ut-robotics/picr21-team-tlo-rock/README.md

# picr21-team-tlo-rock

The robot assigned name is 'TLOROCK'.

Running this code requires the installation of the following external python libraries beforehand:
- pyrealsense2
- cv2
- numpy
- pynput
- websockets
    
To run the python portion of the code navigate to the folder 'robot code' and run the 'main.py' file.    

To run the mainboard code import the tlo project into cube IDE and connect the mainboard to it via ST link. Then press the run button and it should upload it to the mainboard. The mainboard must be connected to a power source via its usb connection.
