ut-robotics/picr21-team-tlo-rock/testing files/camera line concept.png

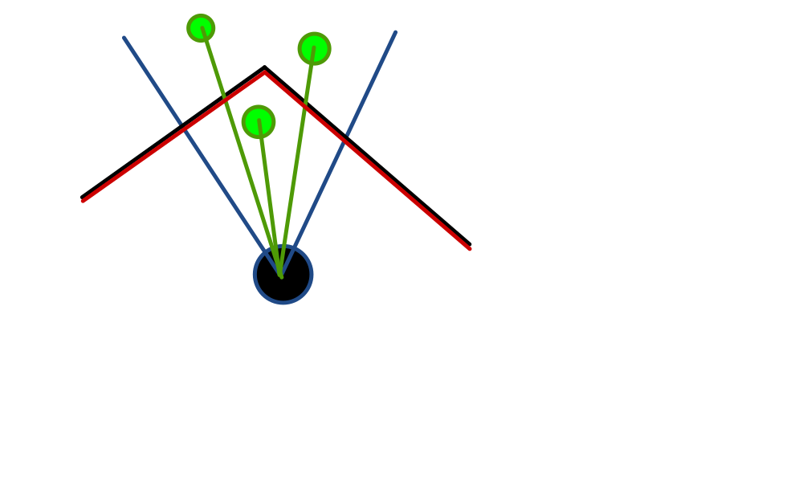
testing files/camera line concept.png
