ut-robotics/picr21-team-tlo-rock/electronics/Mainboard documentation/Mainboard BOM.xlsx

Comment | Description | Designator | Footprint | LibRef | Quantity
Cap Semi | Capacitor (Semiconductor SIM Model) | C1, C2, C3, C4, C5, C6, C10, C10_MOTOR_DRIVE_1, C10_MOTOR_DRIVE_2, C10_MOTOR_DRIVE_3, C11, C11_MOTOR_DRIVE_1, C11_MOTOR_DRIVE_2, C11_MOTOR_DRIVE_3, C13, C13_MOTOR_DRIVE_1, C13_MOTOR_DRIVE_2, C13_MOTOR_DRIVE_3, C14, C15, C16, C17, C18, C19, C20, C21, C22, C23, C24, C25, C26, C27, C28, C29, C30, C31, C32, C33, C34 | 1608[0603] | Cap Semi | 39
470u | 470F 25V Aluminum Electrolytic Capacitors Radial, Can 8000 Hrs @ 105C | C12_MOTOR_DRIVE_1, C12_MOTOR_DRIVE_2, C12_MOTOR_DRIVE_3 | CAPPRD500W60D800H1500 | EEUFR1E471YB | 3
3V3_GOOD | Typical RED, GREEN, YELLOW, AMBER GaAs LED | D1 | 1608[0603] | LED2 | 1
B5V_GOOD | Typical RED, GREEN, YELLOW, AMBER GaAs LED | D2 | 1608[0603] | LED2 | 1
LED | Typical RED, GREEN, YELLOW, AMBER GaAs LED | D3 | 1608[0603] | LED2 | 1
LED2 | Typical RED, GREEN, YELLOW, AMBER GaAs LED | D4_MOTOR_DRIVE_1, D4_MOTOR_DRIVE_2, D4_MOTOR_DRIVE_3 | 1608[0603] | LED2 | 3
10118193-0001LF | USB - micro B USB 2.0 Receptacle Connector 5 Position Surface Mount, Right Angle; Through Hole | J1 | FCI_10118193-0001LF | 10118193-0001LF | 1
FTSH-105-01-XXX-DV-K | TERMINAL STRIP, .050"(1.27mm) PITCH, 10 PINS, KEYED | J2 | FTSH-105-01-XXX-DV-K | FTSH-105-01-XXX-DV-K | 1
7-215079-4 | Micro-MaTch 4 Position 1.27 mm Pitch Vertical Female-on-Board Connector | J3, J4, J5, J6, J7, J8, J9 | TE_7-215079-4 | 7-215079-4 | 7
Inductor | Inductor | L1 | WE-PD-M-PB | Inductor | 1
BAT+ |  | P1 | PCBComponent_1 | Component_1 | 1
BAT- |  | P2 | PCBComponent_1 | Component_1 | 1
M1+ |  | P3 | PCBComponent_1 | Component_1 | 1
M1- |  | P4 | PCBComponent_1 | Component_1 | 1
M2+ |  | P5 | PCBComponent_1 | Component_1 | 1
M2- |  | P6 | PCBComponent_1 | Component_1 | 1
M3+ |  | P7 | PCBComponent_1 | Component_1 | 1
M3- |  | P8 | PCBComponent_1 | Component_1 | 1
BUK6Y10-30P | P-Channel MOSFET | Q1 | TO127P600X120-5N | MOSFET-P | 1
Res2 | Resistor | R1, R2, R3, R4, R5, R6 | J1-0603 | Res2 | 6
Rsr | Resistor | R10_MOTOR_DRIVE_1, R10_MOTOR_DRIVE_2, R10_MOTOR_DRIVE_3 | J1-0603 | Res3 | 3
Rdiag | Resistor | R11_MOTOR_DRIVE_1, R11_MOTOR_DRIVE_2, R11_MOTOR_DRIVE_3 | J1-0603 | Res3 | 3
Rmode | Resistor | R12_MOTOR_DRIVE_1, R12_MOTOR_DRIVE_2, R12_MOTOR_DRIVE_3 | J1-0603 | Res3 | 3
Rtrip | Resistor | R13_MOTOR_DRIVE_1, R13_MOTOR_DRIVE_2, R13_MOTOR_DRIVE_3 | J1-0603 | Res3 | 3
R|PROP| | Resistor | R14_MOTOR_DRIVE_1, R14_MOTOR_DRIVE_2, R14_MOTOR_DRIVE_3 | J1-0603 | Res3 | 3
Rled | Resistor | R15_MOTOR_DRIVE_1, R15_MOTOR_DRIVE_2, R15_MOTOR_DRIVE_3 | J1-0603 | Res3 | 3
CM1223 |  | U1 | SOT23-5 | CM1223 | 1
PDRV8243HRXYQ1 | No Description Available | U1_MOTOR_DRIVE_1, U1_MOTOR_DRIVE_2, U1_MOTOR_DRIVE_3 | RXY0014A-MFG | PDRV8243HRXYQ1 | 3
STM32G441KBT3 | No Description Available | U2 | LQFP32_7X7_STM | STM32G441KBT3 | 1
NCP164C |  | U3 | SOT23-5 | NCP164C | 1
MAX14930 |  | U5, U6, U7 | SOIC16_N | MAX14930 | 3
TPS54227DDA |  | U8 | VREG_LM5017MR/NOPB | TPS54227DDA | 1
