ut-robotics/picr21-team-tlo-rock/electronics/c_comp/ul_STM32G441KBT3/AltiumDesigner/2021-09-23_16-13-24/LQFP32_7X7_STM.step

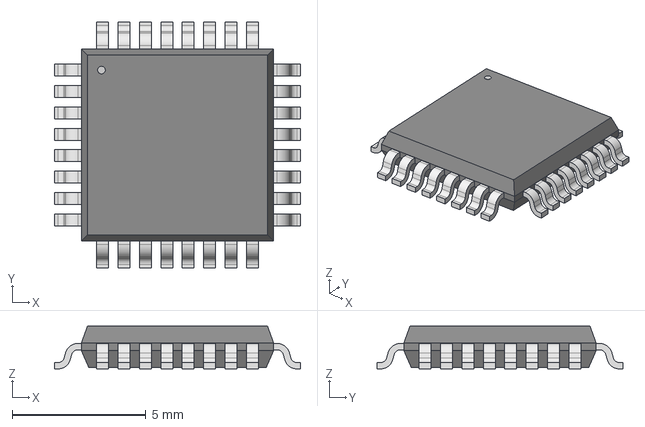
[picture p2: CAD file, 2021-11-29]
electronics/c_comp/ul_STM32G441KBT3/AltiumDesigner/2021-09-23_16-13-24/LQFP32_7X7_STM.step
9.19 x 9.19 x 1.60 mm
