ut-robotics/picr21-team-tlo-rock/(threads)

Thread 16 (2021-10-23):

Use serial.tools.list_ports

ReikoR, 2021-10-23:
https://github.com/ut-robotics/picr21-team-tlo-rock/blob/62c4f6e3b51b6864e3e0457cb11f78cf762dd253/robot%20code/movement_controller.py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

Instead of blindly trying to open ports, use [serial.tools.list_ports](https://pyserial.readthedocs.io/en/latest/tools.html) to find the correct port based on the port info.

peeter-virk, 2021-11-04:
now using serial.tools.list_ports to connect to the board

Closed 2021-11-06.

Thread 20 (2021-10-23):

Simplify omni-movement code

ReikoR, 2021-10-23:
Separate `rotate_omni` function should not be needed. Rotation speed could be an argument of `move_omni` function and added to each wheel speed.

`combine_moves` should also not be needed. In `manual_control.py`, movement speed and angle could be calculated based on the button presses and used as a argument for `move_omni` function. Other uses of `combine_moves` should also be unnecessary when rotation speed is added as an argument to `move_omni` function.

peeter-virk, 2021-11-04:
Change is not worth the time and effort it would take to modify large parts of the current code as well as having to fix all of the potential bugs related to refactoring.

Closed 2021-11-09.

Thread 24 (2021-11-06):

[Mechanics] - motor holder design tweaks

Akustav, 2021-11-06:
2 enhancements:
1. Reduce the radius of the holder, this makes creating it faster and wastes less material
2. Put the shaft fastening hole between the wheel fastening holes. This way there can be no interference bewteen the two fasteners

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

priitro, 2021-11-06:
1. Reduced motor holder radius to 28 mm.
2. Positioned holes around, and now interference will be between two different fasteners.
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
Motor holder sketch
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

Akustav, 2021-11-06:
Maybe we can make it 25? Then we can use 25mm materials

priitro, 2021-11-06:
Its is possible now - diameter is 25 mm and 2 mm from edge of hole to perimeter
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

Akustav, 2021-11-07:
Seems ok now

Closed 2021-11-07.

Thread 25 (2021-11-06):

[Mechanics] - sketch has underdefined elements

Akustav, 2021-11-06:
Check that sketches have no underdefined elements, so they need to be black, not blue:

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

priitro, 2021-11-06:
Changed holes position and defined whit constraints  sketch.
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

Akustav, 2021-11-06:
Seems OK now

Closed 2021-11-06.

Thread 26 (2021-11-07):

[Mechanics] - wheel could damage field elements or robots

Akustav, 2021-11-07:
When the wheel is spinning it could damage parts of the fields (baskets) or robots it hits with bolt heads. You you plan to cover the wheels?

I not maybe recessed screws are better.

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

priitro, 2021-11-07:
1.I have designed wheel cover. I (we - others don't now yet about it ) haven't decided yet use it or not. If we use cover we can use same screws, if not i can change screws type and redesign holes.
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

2. Bottom plate design is`'t ready yet and i don't know whether we use protective edge or not. Right now i have placed motors and wheels to bottom plate and we may have space for edge on it.
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

Akustav, 2021-11-07:
Okay, Seems like you have considered it. Will close

priitro, 2021-11-07:
I redesigned holes - now I can use both screws depending of whether I use cower or not:  Design of screw may be bad but it gives idea I mean.
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

Closed 2021-11-07.

Thread 33 (2021-11-24):

Wrong motor driver package

ReikoR, 2021-11-24:
HVSSOP (28) package is used, but the available drivers are in VQFN-HR (14) package.

Package is also specified in the guide:
https://reikor.github.io/picr21-basketball-robot-guide/electronics/components.html#_motor_driver

JoelJaemaa, 2021-11-29:
New footprint has no thermal pad under it, I will draw that in manually

ReikoR, 2021-12-04:
Still wrong footprint and symbol.

Recommended (available in the lab) component:
https://reikor.github.io/picr21-basketball-robot-guide/electronics/components.html#_motor_driver
>DRV8243
>Product code: PDRV8243HRXYQ1 (HW variant)
>Package: VQFN-HR (14)

From the datasheet:
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

ReikoR, 2021-12-08:
It probably doesn't matter too much, but it would be nice to keep minimum solder mask expansion.

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

JLCPCB specifies the minimum at 0.05 mm.
https://jlcpcb.com/capabilities/Capabilities

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

[Datasheet ](https://www.ti.com/lit/ds/symlink/drv8243-q1.pdf) recommends 0.05 mm.

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

JoelJaemaa, 2021-12-13:
I can't seem to find this in the rules. There is a rule in design rules -> mask -> solder mask expansion -> expansion top and it's set at 4 mil.

ReikoR, 2021-12-14:
For this component it's defined on the component footprint. Component library needs to be changed.

Closed 2022-01-07.

Thread 34 (2021-11-24):

Incorrect microcontroller pins used

ReikoR, 2021-11-24:
USB and programmer signals can be connected only to specific pins. PWM output and encoder input signals can also be connected to limited amount of pins.

Recommended way for finding correct pins is to use Pinout & Configuration view in STM32CubeIDE.

More information can be found on the firmware page in the guide:
https://reikor.github.io/picr21-basketball-robot-guide/electronics/firmware.html

JoelJaemaa, 2021-11-29:
Updated the pins. Let me know if these are okay now

ReikoR, 2021-12-04:
Servo needs a separate timer as it needs different PWM frequency from motors and thrower. PB0 pin does not have any usable timer currently.
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

What interface is accelerometer using? I2C? PA5 and PA10 pins are not connected to anything usable in the MCU.
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

Closed 2021-12-12.

Thread 35 (2021-11-24):

Analog signal can't go through digital isolator

ReikoR, 2021-11-24:
MAX14930 is a digital isolator and the outputs are either low or high.
Some other solution would be needed for measuring voltages on the other side of an isolator.

What is the purpose of measuring battery voltage?

JoelJaemaa, 2021-11-29:
Peeter wanted the ability to measure battery voltage so that we can compensate for speed as the battery voltage drops

ReikoR, 2021-12-04:
Compensate for wheel speeds or thrower speeds?

Wheel motors have encoders for closed loop speed control and voltage regulator can be used to keep the thrower motor controller voltage constant.

Closed 2021-12-12.

Thread 36 (2021-11-24):

Use 0603 package for resistors and smaller capacitors

ReikoR, 2021-11-24:
Most of the passive components in the lab are in 0603 package but some components on the schematic are in 0805 package. It doesn't make sense to order new components if the components with same values are available. For higher capacitances it's ok to use larger packages, but it's better to check what's already available in the lab.

JoelJaemaa, 2021-11-29:
Changed 0805 footprints to 0603

ReikoR, 2021-12-04:
There are still components in 0805 package.

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

JoelJaemaa, 2021-12-06:
Fixed

Closed 2021-12-08.

Thread 37 (2021-11-24):

NCV8730ASN500T1G does not have PG

ReikoR, 2021-11-24:
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

From the [datasheet](https://www.onsemi.com/pdf/datasheet/ncv8730-d.pdf):

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

JoelJaemaa, 2021-11-29:
Removed the LED and resistor atttached to the PG pin and connected them to +5v motor rail and GND instead for checking if we have the voltage.

Closed 2021-12-04.

Thread 38 (2021-11-24):

Use cheaper and simpler connector for GPIO

ReikoR, 2021-11-24:
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

Programmer connector is not very cheap. It has 1.27 mm pitch and is keyed, requiring matching connector to be used.

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

We have pin headers in the lab with 1.27, 2.0 and 2.54 mm pitch and also micromatch connectors with different pin counts.
If really needed, then we can order something else.

JoelJaemaa, 2021-11-29:
Replaced with micromatch 4 connectors for individual addon features

Closed 2021-12-04.

Thread 39 (2021-11-24):

LED is connected in a wrong way to DRV8243 nFAULT pin

ReikoR, 2021-11-24:
Some more info on how to use open drain pins:
https://reikor.github.io/picr21-basketball-robot-guide/electronics/schematic.html#_open_drain_outputs

JoelJaemaa, 2021-11-29:
Yep, accidentaly left that the wrong way around. Fixed it.

Closed 2021-12-04.

Thread 40 (2021-11-24):

Select correct resistors for DRV8243 configuration pins

ReikoR, 2021-11-24:
Some pins can be connected directly to GND, left unconnected or connected with specific resistor to GND.

For example currently ITRIP pin is connected to GND with a 0 Ohm resistor, which results in output current not being limited. I would recommended current limit of around 2 to 3 A. Current limit can be set with resistors connected to ITRIP and IPROPI pins.

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

Relevant information can be found from the datasheet:
https://www.ti.com/lit/ds/symlink/drv8243-q1.pdf

Let me know if more help is needed.

JoelJaemaa, 2021-12-06:
The resistors in the schematic are currently just placeholders so they could be placed on the pcb. I will update them soon.

JoelJaemaa, 2022-01-13:
Changed ITRIP resistor to 47K. Does that seem okay? Rest of them should be fine at 0 ohm (GND)?

ReikoR, 2022-01-14:
Resistor values should be fine, but place the resistor better on the schematic. Currently it's a bit hard to understand which is which.  It would be better to place resistors vertically.

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

JoelJaemaa, 2022-01-24:
Resistor placement fixed. Made other schematic elements nicer as well. Changed the values of feedback resistors in the switching regulator with values that were available in the lab. Same ratio. 5V is nice and stabile.

Closed 2022-01-25.

Thread 44 (2021-11-28):

Refactor min max limiting into separate function

ReikoR, 2021-11-28:
https://github.com/ut-robotics/picr21-team-tlo-rock/blob/f928aeb4cd5ac96405098a886fadbd8b1d98b824/robot%20code/game_logic.py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

peeter-virk, 2021-12-06:
done

ReikoR, 2021-12-10:
https://github.com/ut-robotics/picr21-team-tlo-rock/blob/8d38ac2402675cea33a5d87779682db3a0426ee8/robot%20code/game_logic.py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

Current `minimax` function won't work, because it uses the same names for arguments as built-in functions `min` and `max`.

peeter-virk, 2021-12-11:
Fixed in main

Closed 2021-12-13.

Thread 45 (2021-11-28):

Duplicate camera code

ReikoR, 2021-11-28:
`Camera.py` and `Thresholding.py` contain duplicate camera code.

It would be better to have separate Camera class that can be used for getting frames for regular image processing and thresholding.

Kuulike, 2021-12-06:
moved the thresholding tool into the testing code package

ReikoR, 2021-12-10:
Is the code in `Thresholding.py` not used any more?

Camera code should be in  separate file/class so it can be used by both thresholding and main robot code without duplicating it.

peeter-virk, 2022-01-13:
files have been merged

ReikoR, 2022-01-14:
Putting everything in the same file is not the best solution, but better than before.

Closed 2022-01-14.

Thread 47 (2021-12-04):

Add decoupling capacitor to VDDA

ReikoR, 2021-12-04:
Each VDD/VDDA pin should have separate 100nF capacitor.

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

JoelJaemaa, 2021-12-06:
I placed them near the pins on the PCB. I can correct it in the schematic as well.

ReikoR, 2021-12-08:
There should be additional 100nF capacitor, so that each VDD/VDDA pin would have one.

Closed 2021-12-12.

Thread 48 (2021-12-04):

Wrong package for isolators

ReikoR, 2021-12-04:
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

MAX14930DASE+ isolators are in narrow SOIC package. Wide SOIC package is currently used in the design.

JoelJaemaa, 2021-12-06:
Okay, will fix it

JoelJaemaa, 2021-12-11:
Fixed

Closed 2021-12-12.

Thread 49 (2021-12-04):

Incorrect BUK6Y10-30P symbol

ReikoR, 2021-12-04:
Symbol has 2 extra pins floating around.

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

Only 3 signals are connected to the footprint.

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

In the case where 1 pin connects to multiple pads it's better to use letters as designators instead of numbers:

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

D - drain
S - source
G - gate

Designators with the same name will be connected together. This way the symbol only needs 3 pins.

JoelJaemaa, 2021-12-06:
Fixed it

Closed 2021-12-08.

Thread 53 (2021-12-08):

Use switching regulator for servo power

ReikoR, 2021-12-08:
Linear regulators waste a lot of power when currents are high and voltage difference is big.

JoelJaemaa, 2021-12-11:
Okay, I'll look into it but that linear regulator should work okay for now. It will dissipate more heat but it has a small load and the batteries should be able to handle it. If I have time I will replace it on monday but if not then can we keep it this way? I have the part, no need to order it.

ReikoR, 2021-12-12:
Some recommendations:

1. You can use Texas Instruments Webench to generate the design for the regulator:
https://www.ti.com/design-resources/design-tools-simulation/webench-power-designer.html
Other manufacturers have similar tools available.

2. Check that the regulator is in stock:
https://www.mouser.ee/c/power/power-management-ics/voltage-regulators-switching-regulators/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
There are also some regulators in the lab from last year.

It's not that the batteries are not able to handle it. Linear regulators waste a lot of power. The load from servo is not that small.

JoelJaemaa, 2021-12-13:
Okay. I'll do this tonight.

JoelJaemaa, 2021-12-13:
I'll come by the lab tomorrow and check what we have. Everything the TI Webench recommended is out of stock or on order. I know that a linear regulator is not a good option but I put it in initially because it's what I have. I also do stuff for Estcube so I'll check if we have anything in stock there that I could get. Other than moving stuff from M1 layer and this regulator issue, everything else should be better now.

ReikoR, 2021-12-15:
I ordered these regulators:
https://www.ti.com/product/TPS62933

You can use those or the ones you find in the lab.

I'll probably order these inductors also:
https://ee.farnell.com/bourns/srp6060fa-5r6m/inductor-shld-5-6uh-10a-aec-q200/dp/2901832?st=2901832

JoelJaemaa, 2021-12-15:
Found a couple TPS54227s in the lab. Will use those. I did not check what size inductors we have though.

JoelJaemaa, 2021-12-15:
Schematics and board have been updated with TPS54227 based buck converter

ReikoR, 2021-12-15:
1. Vias in TPS54227 footprint are not connected to GNDB.

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

Footprint has pad 9, but symbol does not have pin 9, so the pad is not connected to anything.

Also it's better to add vias in PCB design not in component footprint. Then it's easier to change via sizes and locations.

2. Inductor used right now is in 1206 (3216 metric) size. I don't think there are any inductors in that size that can meet the recommended specs. TI Webench recommends: L: 4.7 μH - 7.05 μH, DCR: 125 mΩ (max), IDC: 3.64 A (min).

3. More input capacitance should be used. Current values are below the recommendations. It's probably better to use higher capacitance than recommended, because the servo motor could have high peak current draw.

JoelJaemaa, 2021-12-17:
I'd like to change it but this is a downloaded library and not one that I made. So the vias are already there. I'd like to remove the vias and add pin 9. Also edit the other footprints to move stuff around between mechanical layers. How can I do that?

I added more capacitance to the input.

ReikoR, 2021-12-18:
You can open the existing library files and modify them or you can create a new library yourself. It's easy to create components with Tools -> IPC Compliant Footprint Wizard.

JoelJaemaa, 2021-12-23:
Pin 9 GNDB issue fiexd

JoelJaemaa, 2021-12-23:
Proper inductor also used now

ReikoR, 2021-12-27:
1. Which exact inductor are you using in the design? Footprint in the design is for Würth Elektronik 744777930, but that one is not suitable. Würth has 4.7 uF inductors in similar package.

2. Move inductor closer to regulator.

Recommendation from [TPS54227 datasheet](https://www.ti.com/lit/ds/symlink/tps54227.pdf):

> 2\. Keep the SW node as physically small and short as possible to minimize parasitic capacitance and
inductance and to minimize radiated emissions. Kelvin connections should be brought from the output to the
feedback pin of the device.

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

3. Avoid routing anything below the inductor.

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

4. Output capacitance is still below the recommendations.

From TI Webench:

Cin = 20uF (2x 10uF)
Cout = 44uF (2x 22uF)

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

JoelJaemaa, 2021-12-29:
Using a 4.7uH inductor I found in the lab. Has the same footprint. Using this Würth part for the footprint.

JoelJaemaa, 2021-12-29:
Added more capacitance and shortened L1 path.

JoelJaemaa, 2021-12-31:
All issues should be fixed now

ReikoR, 2022-01-01:
This has not been fixed:

3\. Avoid routing anything below the inductor.

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

JoelJaemaa, 2022-01-02:
Fixed

ReikoR, 2022-01-02:
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

Linear regulator is not needed anymore, since the switching regulator can provide the 5V supply.

JoelJaemaa, 2022-01-03:
Removed it and put all the battery side 5V stuff onto the switching regulator

ReikoR, 2022-01-07:
Vias in TPS54227 footprint are again not connected to GNDB. It's better to remove vias from footprint and add them in PCB design.

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

JoelJaemaa, 2022-01-07:
Yeah it does not like to stay connected. Removed them from footprint and added manually. Should be fixed now.

Closed 2022-01-07.

Thread 54 (2021-12-08):

Servo connector should use motors side ground

ReikoR, 2021-12-08:
Currently servo connector is connected to MCU side ground.

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

JoelJaemaa, 2021-12-11:
Fixed

Closed 2021-12-12.

Thread 55 (2021-12-08):

Keep isolated sides completely separate

ReikoR, 2021-12-08:
MCU side and motors side should be physically separated on the board. Only things crossing the isolation gap should be the isolators.

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

JoelJaemaa, 2021-12-11:
Fixed

Closed 2021-12-12.

Thread 57 (2021-12-08):

Connect decoupling capacitors as close as possible to the components

ReikoR, 2021-12-08:
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

Track inductance should be minimized by keeping them as short as possible, otherwise decoupling capacitors won't be as effective.

JoelJaemaa, 2021-12-11:
Fixed

ReikoR, 2021-12-12:
Capacitors need to be much closer.

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

JoelJaemaa, 2021-12-13:
Fixed

ReikoR, 2021-12-15:
Decoupling capacitors for motor driver VM pins could be be closer to the drivers by putting capacitors to bottom layer and connecting them with vias.

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

JoelJaemaa, 2021-12-17:
Fixed. Also added an extra 4.7uf cap there. Moved both to bottom.

Closed 2021-12-27.

Thread 58 (2021-12-08):

Connect ESD protection as close as possible to connector

ReikoR, 2021-12-08:
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

Connecting ESD protection close to the connector helps to prevent ESD spikes from propagating to other components.

JoelJaemaa, 2021-12-11:
Fixed

Closed 2021-12-12.

Thread 59 (2021-12-08):

USB connector ground not connected

ReikoR, 2021-12-08:
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

JoelJaemaa, 2021-12-11:
Fixed

Closed 2021-12-12.

Thread 60 (2021-12-08):

Avoid routing ground

ReikoR, 2021-12-08:
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

Ground should be connected to internal ground layer(s) with vias as close as possible to component pads.

JoelJaemaa, 2021-12-11:
Fixed

ReikoR, 2021-12-12:
Vias should be as close as possible to pads to reduce inductance from tracks.

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

JoelJaemaa, 2021-12-13:
Fixed the long grounds

ReikoR, 2021-12-15:
This via could still be closer:
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

Why are you using the default via size everywhere? Vias can be smaller and moved closer to the pads.

Design rule for via sizes can be changed:
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

JoelJaemaa, 2021-12-17:
Used a smaller via and placed it closer.
I'm using default size because I did not necessarily need to use any other size before.

Closed 2021-12-27.

Thread 61 (2021-12-08):

Use wider tracks or polygons for higher currents

ReikoR, 2021-12-08:
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

JoelJaemaa, 2021-12-11:
I tried making some improvements. Hopefully it should be a bit better now.

ReikoR, 2021-12-12:
It's better, but you should move the tracks a bit and use smaller vias (at least for signals) to make power tracks for drivers wider.

Driver's VM capacitors should also be as close to the driver as possible. SMD capacitors can also be on the bottom of the board and connected with vias.

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

JoelJaemaa, 2021-12-13:
Will do it tonight

JoelJaemaa, 2021-12-13:
I managed to get the caps a bit closer and unchecked the option that removes loops from traces. This allowed me to get more vias on one trace and get the motor driver power connections connected from both sides.

Closed 2021-12-27.

Thread 62 (2021-12-08):

Board outline should be drawn on Mechanical 1 (M1) layer

ReikoR, 2021-12-08:
Currently it's on top layer, which is for top layer copper.

There are some other things on M1 layer, which should be moved to some other layers.

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

Component bodies are typically placed on M13 (Top 3D Body) or M14 (Bottom 3D Body) layers.

JoelJaemaa, 2021-12-11:
Moved outline to M1. Can't move other stuff on M1 to M13 or M14. It only lets me choose top, bottom or the two middle GND layers. Can I move them to one of these?

ReikoR, 2021-12-12:
Other stuff needs to be moved in component libraries.

JoelJaemaa, 2021-12-13:
Will fix tonight

JoelJaemaa, 2021-12-23:
I moved the stuff in libraries but it does not seem to update on the PCB. Even after deleting and re-adding the component. Can you help me with this, please? Otherwise it should all be done. Regulator stuff is fixed as well now.

ReikoR, 2021-12-27:
You probably need to use **Tools -> Update From PCB Libraries...** to update the footprints.

JoelJaemaa, 2021-12-31:
Should be fixed now

Closed 2022-01-01.

Thread 63 (2021-12-08):

Board could be smaller

ReikoR, 2021-12-08:
Preferred size is 50 x 50 mm or smaller, because this size is cheaper.

JoelJaemaa, 2021-12-11:
Unfortunately I don't have time to do that. I'll pay the difference from my own pocket if need be.

ReikoR, 2021-12-12:
University courses don't work like that.

Current board could clearly be smaller, even if it does not fit into 50 x 50 mm size.

JoelJaemaa, 2021-12-13:
Okay, I'll try to make it a bit smaller but I'm afraid I don't have time to re-design it too much.

JoelJaemaa, 2021-12-13:
I managed to make the board a bit smaller. Not a lot but at least a bit.

Closed 2022-01-07.

Thread 64 (2021-12-08):

Mounting holes

ReikoR, 2021-12-08:
If there are no other options planned for attaching the board, then some mounting holes should be added.

JoelJaemaa, 2021-12-11:
Added some

Closed 2021-12-12.

Thread 66 (2021-12-12):

Avoid overlapping schematic objects

ReikoR, 2021-12-12:
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

JoelJaemaa, 2021-12-13:
Fixed

Closed 2021-12-15.

Thread 67 (2021-12-12):

Un-routed nets

ReikoR, 2021-12-12:
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

Use Tools -> Design Rules Check... to find problems in the PCB design.

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

JoelJaemaa, 2021-12-13:
Fixed

Closed 2021-12-15.

Thread 69 (2021-12-14):

Depth frame not aligned

Akustav, 2021-12-14:
You currently do not align the depth frame to the color one. This can result in wrong distance readings.

https://github.com/ut-robotics/picr21-team-tlo-rock/blob/b54554c1068070ccf952da579a595b7e8e827c08/robot%20code/Camera.py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

An example:
https://github.com/IntelRealSense/librealsense/blob/master/wrappers/python/examples/align-depth2color.py

peeter-virk, 2022-01-17:
added aligning to depth frames

Closed 2022-01-17.

Thread 70 (2021-12-14):

Very confusing variable naming

Akustav, 2021-12-14:
Variable names like noball is quite bad for the readability of the code. Its concept is described in this one comment line and later on used.

https://github.com/ut-robotics/picr21-team-tlo-rock/blob/b54554c1068070ccf952da579a595b7e8e827c08/robot%20code/main.py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

When I look here it seems like a integer from 0 to 1 that works as a boolean:
https://github.com/ut-robotics/picr21-team-tlo-rock/blob/b54554c1068070ccf952da579a595b7e8e827c08/robot%20code/game_logic.py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

But below it is:
https://github.com/ut-robotics/picr21-team-tlo-rock/blob/b54554c1068070ccf952da579a595b7e8e827c08/robot%20code/game_logic.py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

Overall very unclear as to what the noball variable does.

peeter-virk, 2021-12-17:
It is time since last ball was detected or the time no ball has been in any camera frame.

ReikoR, 2022-01-12:
Variable name should be changed to something that is easier to understand. For example `no_ball_time`.

peeter-virk, 2022-01-13:
Contrary to a common belief longer variable names do not make the code more readable. There are reasons that comments exist. Besides, it isn't such a big issue  if it was, it should have been brought up earlier. Changing variable names now is just a great way to introduce bugs into the code which will only cause more problems down the line.

ReikoR, 2022-01-14:
Problem is not with the length of the name. Short names are only better if they are able describe the purpose of the variable. This issue was created because it is hard to understand what the variable does.

IDEs have refactoring tools to help rename variables:
https://code.visualstudio.com/docs/editor/refactoring#_rename-symbol
https://www.jetbrains.com/help/pycharm/rename-refactorings.html

You can even use GitHub to find where it is used:
https://github.com/ut-robotics/picr21-team-tlo-rock/search?q=noball

peeter-virk, 2022-01-17:
fixed it

Closed 2022-01-17.

Thread 71 (2021-12-15):

Use LEDs in 0603 package

ReikoR, 2021-12-15:
LEDs in the design are in 1206 package, but the ones in the lab are in 0603 package.

JoelJaemaa, 2021-12-17:
Fixed

Closed 2021-12-27.

Thread 72 (2021-12-15):

Check and fix design rule errors

ReikoR, 2021-12-15:
For example in current design:

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

JoelJaemaa, 2021-12-17:
That was an accidental reduntant trace from moving stuff. Will look over them and fix.

ReikoR, 2022-01-01:
1. **Short-Circuit Constraint Violation** and **Hole To Hole Clearance Constraint Violation**

Remove holes inside the slots in USB connector footprint. These are not needed.

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

2. **Hole Size Constraint Violations**

Increase Maximum value in HoleSize rule.

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

[JLCPCB Capabilities](https://jlcpcb.com/capabilities/Capabilities):
Drill Hole Size: 0.20mm- 6.30mm

JoelJaemaa, 2022-01-02:
Fixed

Closed 2022-01-02.

Thread 74 (2021-12-27):

Improve reference designator locations

ReikoR, 2021-12-27:
1. Don't place designators on pads or vias:

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

2. Put designators close to components:

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

Text can be made smaller, if it's difficult to place the designators.

From JLCPCB capabilites:

Minimum Line Width: 6 mil (0.153mm)
Minimum text height: 40 mil (1.0mm)

https://jlcpcb.com/capabilities/Capabilities

3. Don't overlap designators with other text or lines on silkscreen layer.

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

JoelJaemaa, 2021-12-29:
Fixed

Closed 2022-01-02.

Thread 75 (2021-12-27):

Use tented vias

ReikoR, 2021-12-27:
Using tented vias might make the soldering a bit easier by helping to avoiding the solder from flowing into vias.

Also might help to avoid shorts when vias are close to different component pads. There does not seem to be any vias like that in the design.

Probably the easiest option to use tented vias, is to create new Solder Mask Expansion rule for vias:

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

Vias under the the driver's are quite big and might make soldering harder even when being tented. It might be better to use small (0.2/0.45) vias, that don't pull away so much solder from the pads.

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

JoelJaemaa, 2021-12-29:
Added this rule

ReikoR, 2022-01-01:
Can't see the rule and vias not tented either:

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

JoelJaemaa, 2022-01-02:
Should be fixed now. Last time Altium crashed while saving and looks like some changes were not saved.

Closed 2022-01-02.

Thread 76 (2021-12-27):

Connect driver nSLEEP to MCU

ReikoR, 2021-12-27:
More info:
https://github.com/ut-robotics/picr21-team-shaq/issues/50

JoelJaemaa, 2021-12-29:
Done

Closed 2022-01-01.

Thread 78 (2022-01-02):

Add fasteners to top and bottom of thrower

Akustav, 2022-01-02:
I suggest adding fasteners to the top of the thrower, else it might bend inwards since nothing is stopping this:
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

There are also no fastener holes on the bottom.

priitro, 2022-01-03:
Added fasteners to top an bottom of thrower.
top
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
bottom
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

Closed 2022-01-08.

Thread 79 (2022-01-02):

Add stoppers to top of battery holder

Akustav, 2022-01-02:
I would add a stopper to the top of the holder. Additionally i would remove the bottom tab since it can make it hard to operate:

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

priitro, 2022-01-03:
Removed bottom tab. Now its may be not necessary to add stopper to top?
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

Akustav, 2022-01-08:
Maybe just in case round the corners off, then it is harder to cut into a battery and damage it?

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

priitro, 2022-01-08:
Made arc  cut
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

priitro, 2022-01-08:
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

Closed 2022-01-08.

Thread 80 (2022-01-02):

USB ports on opposite side of machine

Akustav, 2022-01-02:
Currently the USB exposed USB ports are on the other side of the robot compared to mainboard and camera USB ports. This is by design?

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

priitro, 2022-01-07:
Measured cables length and better management and decided stay on that deign. Created one additional hole  for camera cable. And did two slots both side of camera and Nuc stand for fixing cables.
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

Closed 2022-01-08.

Thread 81 (2022-01-02):

Add supports to thrower internal ramp

Akustav, 2022-01-02:
I suggest adding some cutouts to the top plate of the chassis. This reduces the possibility that the ramp bends. the ramp there is quite thin.:
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

priitro, 2022-01-03:
Added supporting top plate body.  Between ramps it is lower because if it`s in a same distance it would resist free ball movement. Throwing motor squeeze's ball between ramps.  Right now distance is 3,55mm
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

Akustav, 2022-01-08:
I would suggest making the dogbones something like this:
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

Then the ramp is better supported in the direction most forces will apply to it.

priitro, 2022-01-08:
Made corrections:
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

Closed 2022-01-08.

Thread 82 (2022-01-02):

Top plate very close to wheel

Akustav, 2022-01-02:
I would increase clearance between t he wheel and top of the chassis:

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

priitro, 2022-01-03:
Cut off part of top plate now

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

Closed 2022-01-08.

Thread 83 (2022-01-08):

Add ball sensor holders

Akustav, 2022-01-08:
Currently these components are missing.

priitro, 2022-01-08:
Both holders are now created and added
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

Closed 2022-01-08.

Thread 84 (2022-01-08):

Servo mounting holes too large

Akustav, 2022-01-08:
I suggest using a 2.5mm M3 hole here:

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

priitro, 2022-01-08:
Changed to M3 (2.5)

Closed 2022-01-08.

Thread 85 (2022-01-08):

Idea about roller removability

Akustav, 2022-01-08:
If you want the roller to be simple to remove then you can make a cutout to the side that allows you to pull out the whole roller assembly. It removes some supportive material but i think it is usable

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

priitro, 2022-01-08:
Yes its easiest way to remove roller. Hope servo stays in place.
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

Closed 2022-01-08.

Thread 87 (2022-01-08):

Interference with servo

Akustav, 2022-01-08:
Currently there is quite some interference between the servo and the side wall:

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

priitro, 2022-01-08:
Problem was with pocket - it wasn´t in right measurements and partly cut.
Now it fits to its pocket.
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

Closed 2022-01-09.

Thread 88 (2022-01-08):

Interference in sharp edges on bottom of chassis

Akustav, 2022-01-08:
There is some interference between the thrower ramps and bottom plate:

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

priitro, 2022-01-08:
Missed that point then mounted thrower. Now corrected.
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

priitro, 2022-01-08:
No interferences detected.
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

Closed 2022-01-09.

Thread 89 (2022-01-09):

Top plate seems difficult to remove

maidlam, 2022-01-09:
How is the top plate removal planned?
The top plate seems to be unable to move in any direction other than up and down a few mm, and unremovable without removing the thrower or ramps.
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

Because of the battery box, the plate can't be removed at an angle.

One way of insertion would be to extend the cutout, and have the NUC and ramp top bolts removed for the duration of the top plate insertion.
This would also require extending the wires of the power switches and NUC power socket.
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

priitro, 2022-01-09:
Unfortunately planning that top plate design, the thrower`s ramps height never come to mind. Its not good!

Made following changes in design:
*changed throwers throwing angel from 58 to 65 degrees. It gives 1mm cut off from thrower height, with regular thrower more than 5 mm.
*lifted thrower and ramp middle holding bolt 5mm
*lifted camera 5mm
*lifted NUC  and connectors holes  ca 10 mm
*increased cutoff of the camera and NUC stand 28 mm
Now it gives 5.4 mm space  (10.25-4.8)  for plate insertion and removal.
-unfortunately  ramps upper polts must remove before.
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

For regular thrower with throwing angle 65 degrees, maybe ramp don't need upper bolts for supporting.
Space for insertion-removal top plate is 14.9 mm (19.7-4.8mm).
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

priitro, 2022-01-13:
If I turned the batteries to a narrower side, the NUC could no longer be switched on. Battery box seen with new dimensions 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

Closed 2022-01-25.
