ut-robotics/picr21-team-tlo-rock/electronics/Mainboard documentation/MCU schematic.pdf

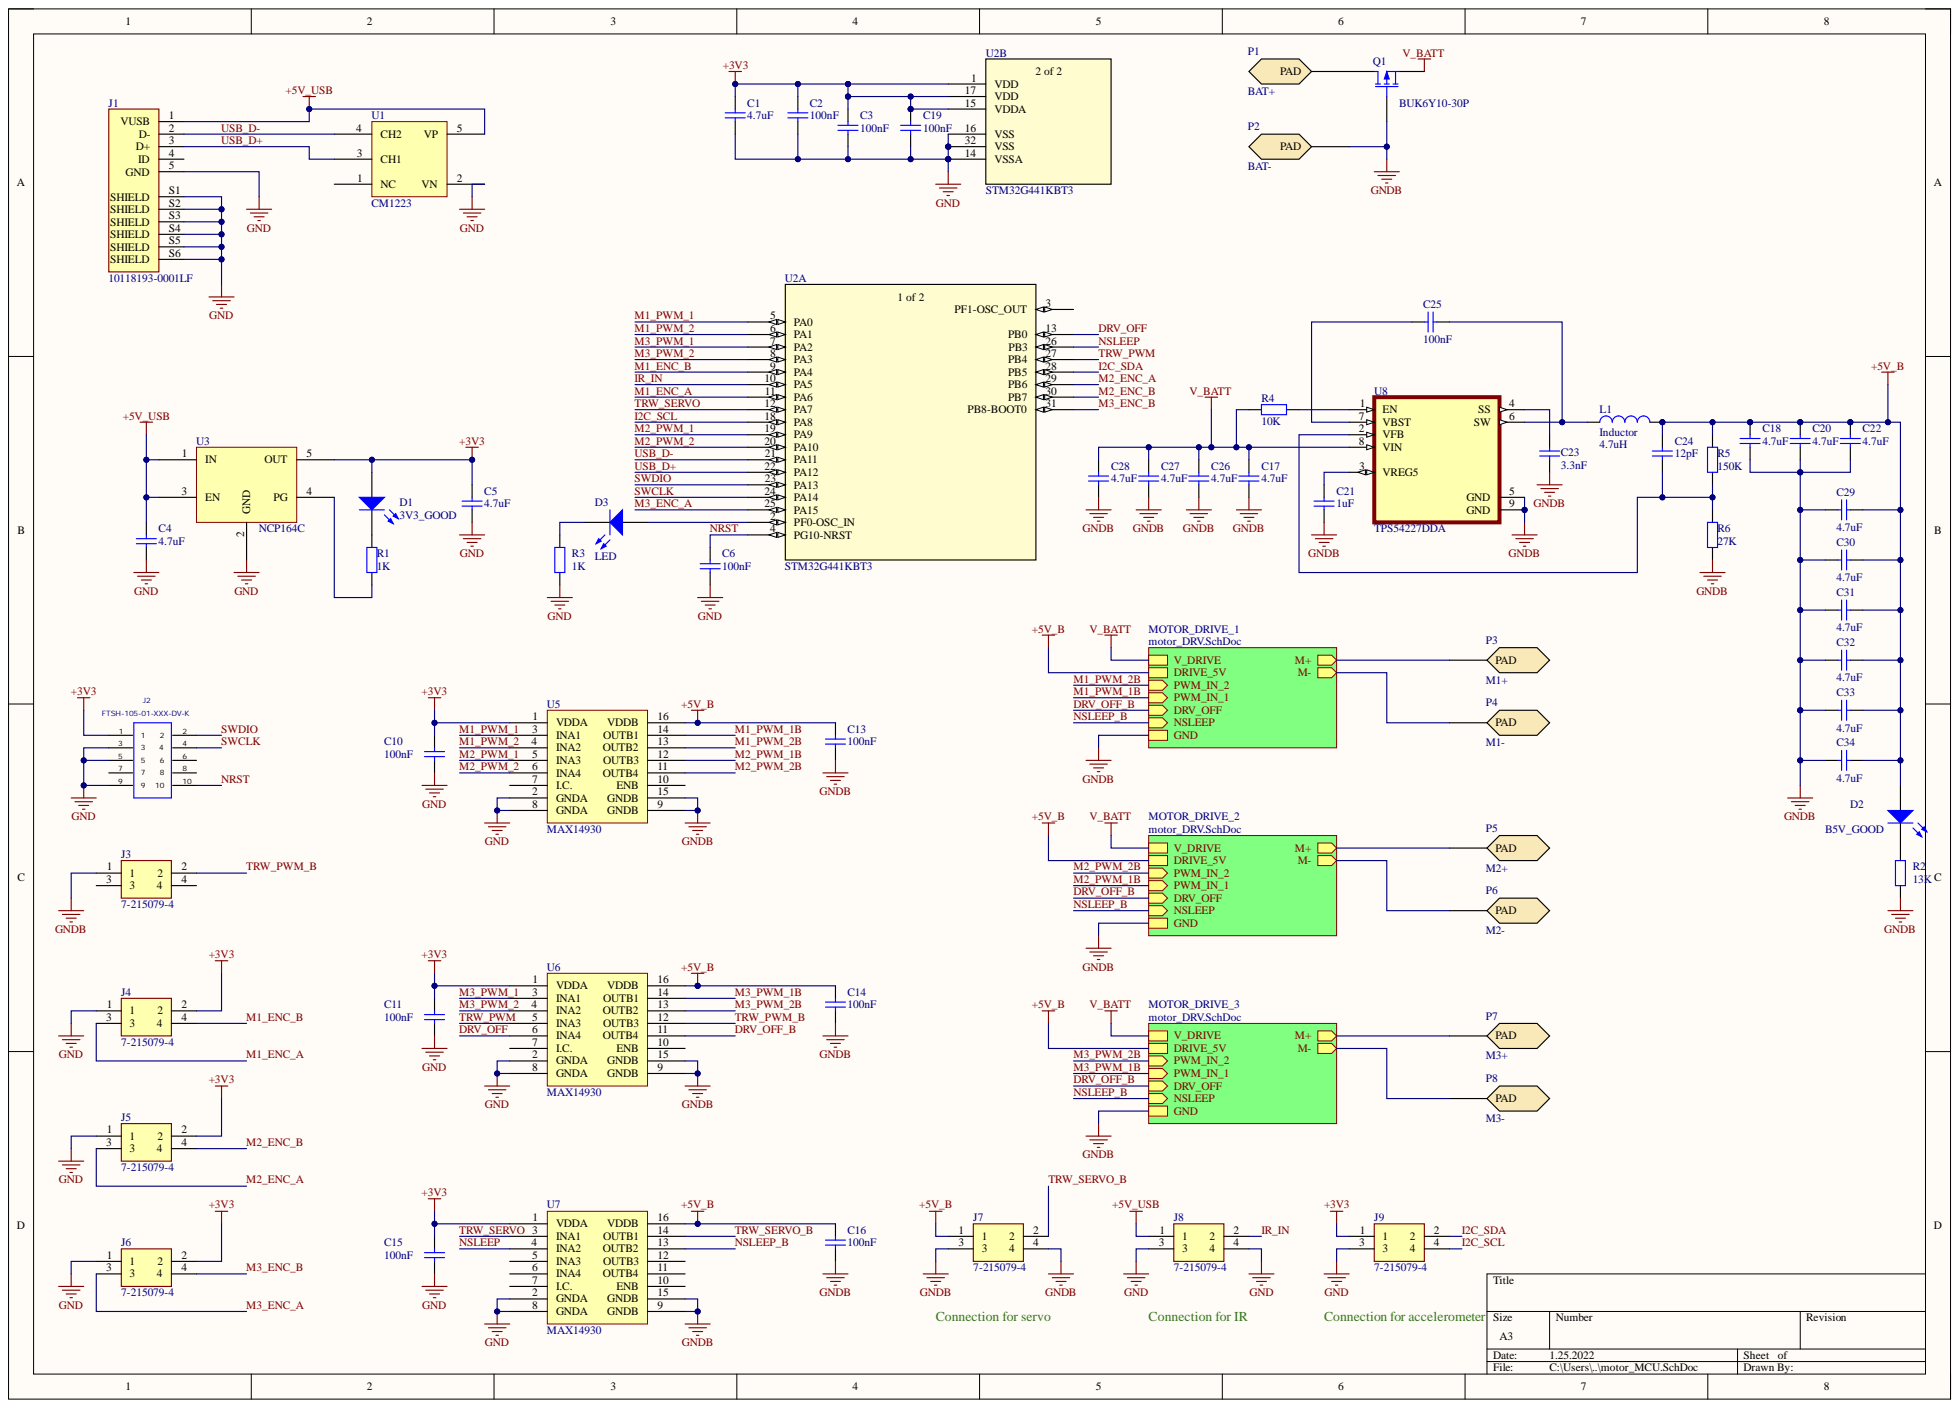
[picture p3: page 1]

EN 1
VBST 7
