ut-robotics/picr21-team-tlo-rock/electronics/Mainboard documentation/Motor driver schematics.pdf

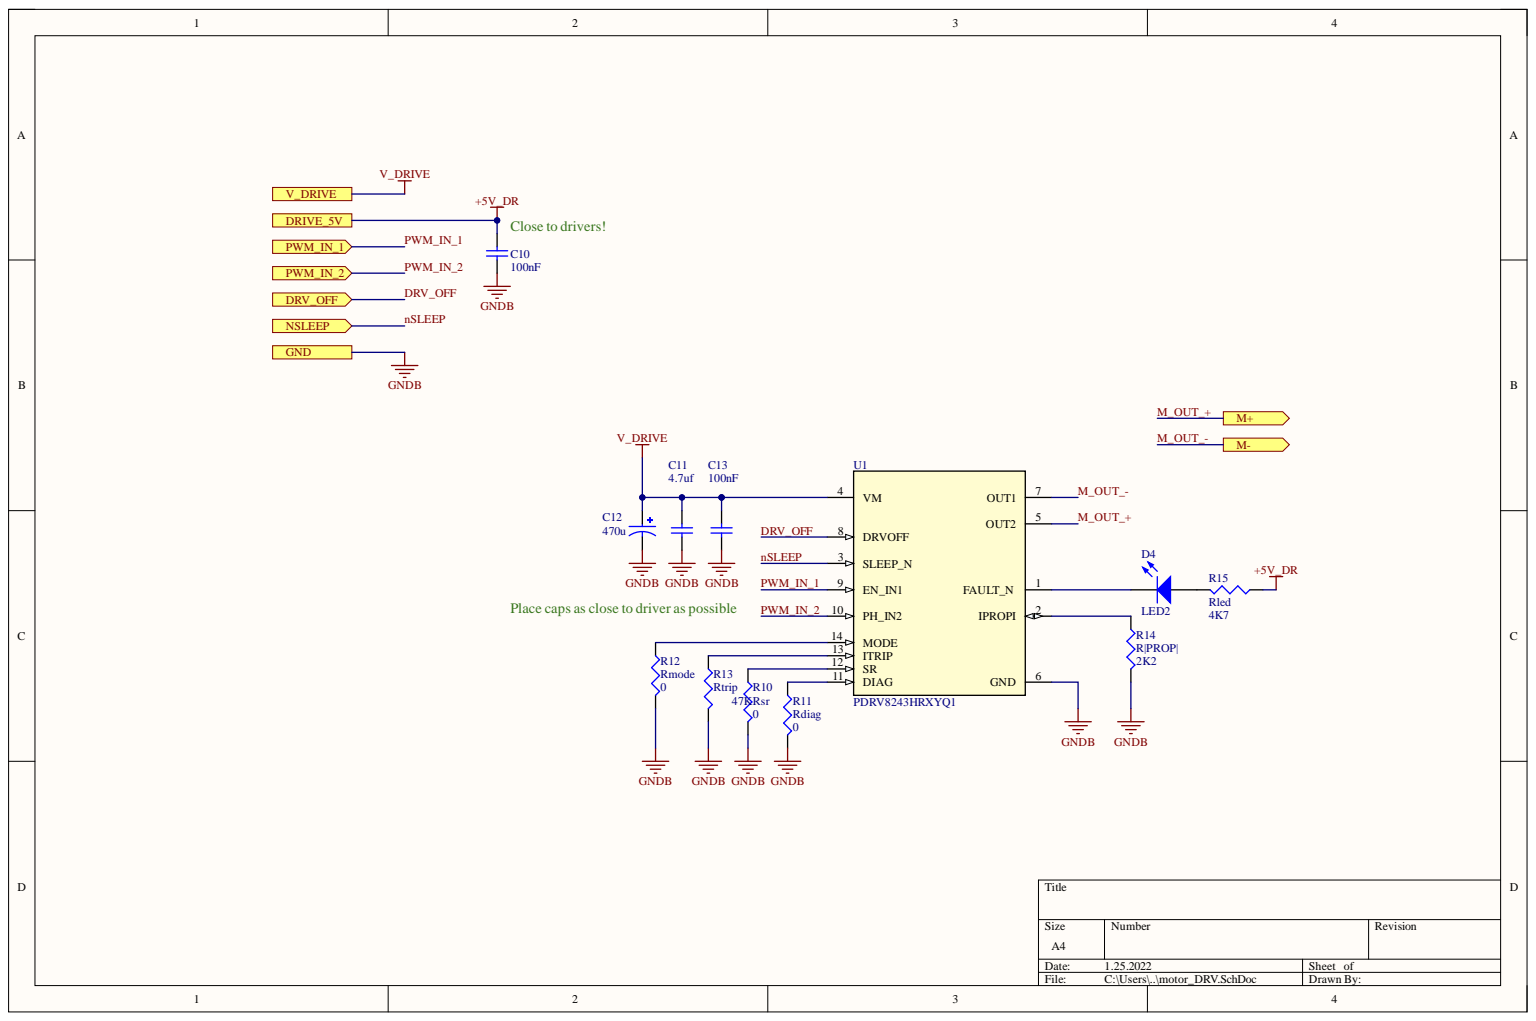
[picture p4: page 1]
