ut-robotics/picr21-team-tlo-rock/(list of files, drawings)

Other design files:
electronics/c_comp/10118193-0001LF1/SnapEDApcb.PcbLib
electronics/c_comp/10118193-0001LF1/SnapEDAsch.SchLib
electronics/c_comp/AU9540-GBS-GR.PcbLib
electronics/c_comp/BUK6Y10-30P.SchLib
electronics/c_comp/CM1223-02SO.SchLib
electronics/c_comp/DRV8243-Q1.SchLib
electronics/c_comp/FTSH-105-01-XXX-DV-K--Symbol-Altium-44987/FTSH-105-01-XXX-DV-K.PcbLib
electronics/c_comp/FTSH-105-01-XXX-DV-K--Symbol-Altium-44987/FTSH-105-01-XXX-DV-K.SCHLIB
electronics/c_comp/Ind_Wurth Electronics_744777930/parts/Wurth_Electronics_744777930.SchLib
electronics/c_comp/Ind_Wurth Electronics_744777930/parts/Wurth_Electronics_744777930_0.PcbLib
electronics/c_comp/MAX14930.SchLib
electronics/c_comp/NCP164C.SchLib
electronics/c_comp/NCV8730.SchLib
electronics/c_comp/powerpad140x175.SchLib
electronics/c_comp/powerpad.PcbLib
electronics/c_comp/SOIC16.PcbLib
electronics/c_comp/SOT23-5.PcbLib
electronics/c_comp/TO127P600X120-5N.PcbLib
electronics/c_comp/TPS54227DDA/TPS54227DDA.SchLib
electronics/c_comp/TPS54227DDA/VREG_LM5017MR_NOPB.PcbLib
electronics/c_comp/Trans_NXP Semiconductors_BUK9Y21-40E,115/parts/NXP_Semiconductors_BUK9Y21_40E_115.SchLib
electronics/c_comp/Trans_NXP Semiconductors_BUK9Y21-40E,115/parts/NXP_Semiconductors_BUK9Y21_40E_115_0.PcbLib
electronics/c_comp/Trans_NXP Semiconductors_BUK9Y21-40E,115/parts/NXP_Semiconductors_BUK9Y21_40E_115_1.PcbLib
electronics/c_comp/Trans_NXP Semiconductors_BUK9Y21-40E,115/parts/NXP_Semiconductors_BUK9Y21_40E_115_2.PcbLib
electronics/c_comp/TSSOP5.PcbLib
electronics/c_comp/ul_PDRV8243HRXYQ1/AltiumDesigner/2021-12-03_16-47-21/PDRV8243HRXYQ1.PcbLib
electronics/c_comp/ul_PDRV8243HRXYQ1/AltiumDesigner/2021-12-03_16-47-21/PDRV8243HRXYQ1.SchLib
electronics/c_comp/ul_STM32G441KBT3/AltiumDesigner/2021-09-23_16-13-24/STM32G441KBT3.PcbLib
electronics/c_comp/ul_STM32G441KBT3/AltiumDesigner/2021-09-23_16-13-24/STM32G441KBT3.SchLib
electronics/TLO Rock electronics/motor_driver.SchDoc
electronics/TLO Rock electronics/motor_DRV.SchDoc
electronics/TLO Rock electronics/motor_MCU.SchDoc
electronics/TLO Rock electronics/PCB.PcbDoc
electronics/TLO Rock electronics/TLO Rock electronics.PrjPcb
