ut-robotics/picr21-team-tlo-rock/workspace_1.8.0/tlo/Core/Src/main.c

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
/* Includes ------------------------------------------------------------------*/
#include "main.h"
#include "usb_device.h"

I2C_HandleTypeDef hi2c3;

TIM_HandleTypeDef htim1;
TIM_HandleTypeDef htim2;
TIM_HandleTypeDef htim3;
TIM_HandleTypeDef htim4;
TIM_HandleTypeDef htim6;
TIM_HandleTypeDef htim8;
TIM_HandleTypeDef htim15;
TIM_HandleTypeDef htim16;
TIM_HandleTypeDef htim17;

/* USER CODE BEGIN PV */
double Lpos_M1 = 0;
double Lpos_M2 = 0;
double Lpos_M3 = 0;

double tgt_M1 = 0;
double tgt_M2 = 0;
double tgt_M3 = 0;

double integral_M1 = 0;
double integral_M2 = 0;
double integral_M3 = 0;

double last_err_M1 = 0;
double last_err_M2 = 0;
double last_err_M3 = 0;

uint32_t thrower_speed = 0;
uint8_t grabber_on = 0;
uint8_t thrower = 0;
uint8_t safety_iters = 0;

volatile int16_t return_M1 = 0;
volatile int16_t return_M2 = 0;
volatile int16_t return_M3 = 0;




/* USER CODE END PV */

void SystemClock_Config(void);
static void MX_GPIO_Init(void);
static void MX_TIM3_Init(void);
static void MX_TIM4_Init(void);
static void MX_TIM6_Init(void);
static void MX_TIM8_Init(void);
static void MX_TIM2_Init(void);
static void MX_TIM16_Init(void);
static void MX_TIM17_Init(void);
static void MX_TIM15_Init(void);
static void MX_I2C3_Init(void);
static void MX_TIM1_Init(void);
/* USER CODE BEGIN 0 */

typedef struct Command {
	int16_t speed1;
	int16_t speed2;
	int16_t speed3;
	uint16_t bools;
	uint32_t thrower_speed;
	uint32_t delimiter;
}Command;

typedef struct Feedback {
	int16_t speed1;
	int16_t speed2;
	int16_t speed3;
	uint16_t bools;
	uint32_t deliminer;
}Feedback;

Command command = {.speed1 = 0, .speed2 = 0, .speed3 = 0, .thrower_speed = 0, .bools = 0, .delimiter = 0xAAAA};
Feedback feedback = {.speed1 = 0, .speed2 = 0, .speed3 = 0, .bools = 0, .deliminer = 0xAAAA};

volatile uint8_t isCommandReceived = 0;

void CDC_On_Receive(uint8_t* buffer, uint32_t* length) //uint8_t* Buf, uint32_t* Len
{
	if (*length == sizeof(Command)){
		memcpy(&command, buffer, sizeof(Command));
	}
	if (command.delimiter == 0xAAAA){
		isCommandReceived = 1;
	}
}

void throw(uint32_t speed)
{
	if (speed > 7500) speed = 7500;
	if (speed < 2500) speed = 2500;
	TIM16->CCR1 = speed;
	HAL_Delay(400);
	TIM17->CCR1 = 1000;
	int n = 1;
	while (n)
	{
		n = HAL_GPIO_ReadPin(BALL_SENSOR_GPIO_Port, BALL_SENSOR_Pin);
		HAL_Delay(200);
	}
	TIM17->CCR1 = 0;
	TIM16->CCR1 = 2500;
}

void HAL_TIM_PeriodElapsedCallback(TIM_HandleTypeDef *htim)
{
	int16_t Cpos_M1 = (int16_t)TIM3->CNT;
	feedback.speed1  = Cpos_M1;
	double dif_M1 = Cpos_M1 - Lpos_M1;
	Lpos_M1 = Cpos_M1;

	int16_t Cpos_M2 = (int16_t)TIM4->CNT;
	feedback.speed2  = Cpos_M2;
	double dif_M2 = Cpos_M2 - Lpos_M2;
	Lpos_M2 = Cpos_M2;

	int16_t Cpos_M3 = (int16_t)TIM8->CNT;
	feedback.speed3  = Cpos_M3;
	double dif_M3 = Cpos_M3 - Lpos_M3;


	double Err1 = tgt_M1/15 - dif_M1;
	double Err2 = tgt_M2/15 - dif_M2;
	double Err3 = tgt_M3/15 - dif_M3;

	double kp = 4000;
	double ki = 700;
	double kd = 300;

	integral_M1 += Err1;
	integral_M2 += Err2;
	integral_M3 += Err3;

	if (integral_M1 > 40) integral_M1 = 40;
	if (integral_M1 < -40) integral_M1 = -40;

	if (integral_M2 > 40) integral_M2 = 40;
	if (integral_M2 < -40) integral_M2 = -40;

	if (integral_M3 > 40) integral_M3 = 40;
	if (integral_M3 < -40) integral_M3 = -40;

	double derivative_M1 = (Err1 - last_err_M1);
	double derivative_M2 = (Err2 - last_err_M2);
	double derivative_M3 = (Err3 - last_err_M3);

	last_err_M1 = Err1;
	last_err_M2 = Err2;
	last_err_M3 = Err3;

	int32_t Speed_M1 = (int32_t) Err1 * kp + integral_M1 * ki + derivative_M1 * kd;
	int32_t Speed_M2 = (int32_t) Err2 * kp + integral_M2 * ki + derivative_M2 * kd;
	int32_t Speed_M3 = (int32_t) Err3 * kp + integral_M3 * ki + derivative_M3 * kd;

	if (tgt_M1 == 0){
		Speed_M1 = 0;
	}
	if (tgt_M2 == 0){
			Speed_M2 = 0;
		}
	if (tgt_M3 == 0){
			Speed_M3 = 0;
		}
	if (Speed_M1 >= 0) HAL_GPIO_WritePin(M1_DIR_GPIO_Port, M1_DIR_Pin, 0);
	else HAL_GPIO_WritePin(M1_DIR_GPIO_Port, M1_DIR_Pin, 1);

	if (Speed_M2 >= 0) HAL_GPIO_WritePin(M1_DIR_GPIO_Port, M2_DIR_Pin, 0);
	else HAL_GPIO_WritePin(M2_DIR_GPIO_Port, M2_DIR_Pin, 1);

	if (Speed_M3 >= 0) HAL_GPIO_WritePin(M1_DIR_GPIO_Port, M3_DIR_Pin, 0);
	else HAL_GPIO_WritePin(M3_DIR_GPIO_Port, M3_DIR_Pin, 1);

	TIM2->CCR1 = abs(Speed_M1);
	TIM2->CCR3 = abs(Speed_M2);
	TIM15->CCR1 = abs(Speed_M3);

	safety_iters++;
}


/* USER CODE END 0 */

/**
  * @brief  The application entry point.
  * @retval int
  */
int main(void)
{
  /* MCU Configuration--------------------------------------------------------*/

  /* Reset of all peripherals, Initializes the Flash interface and the Systick. */
  HAL_Init();

  /* Configure the system clock */
  SystemClock_Config();

  /* Initialize all configured peripherals */
  MX_GPIO_Init();
  MX_TIM3_Init();
  MX_TIM4_Init();
  MX_TIM6_Init();
  MX_TIM8_Init();
  MX_TIM2_Init();
  MX_TIM16_Init();
  MX_TIM17_Init();
  MX_TIM15_Init();
  MX_I2C3_Init();
  MX_TIM1_Init();
  MX_USB_Device_Init();
  /* USER CODE BEGIN 2 */
  // set motors off
  HAL_GPIO_WritePin(DRV_OFF_GPIO_Port, DRV_OFF_Pin, 1);

  // toggle nsleep for aprox 27us
  TIM2->CCR2 = 65100;
  HAL_TIM_PWM_Start(&htim2, TIM_CHANNEL_2);
  // set nsleep to high
  HAL_Delay(100);
  TIM2->CCR2 = 65536;

  //motor speeds to zero
  TIM2->CCR1 = 0;
  TIM15->CCR1 = 0;
  TIM2->CCR3 = 0;

  //begin motor pwm
  HAL_TIM_PWM_Start(&htim2, TIM_CHANNEL_1);
  HAL_TIM_PWM_Start(&htim2, TIM_CHANNEL_3);
  HAL_TIM_PWM_Start(&htim15, TIM_CHANNEL_1);

  //enable thrower and arm it while setting its speed to 0
  HAL_TIM_PWM_Start(&htim16, TIM_CHANNEL_1);
  TIM16->CCR1 = 2500;
  HAL_Delay(4000);

  //enable grabber and set its speed to zero
  TIM17->CCR1 = 0;
  HAL_TIM_PWM_Start(&htim17, TIM_CHANNEL_1);

  //start encoders
  HAL_TIM_Encoder_Start(&htim3, TIM_CHANNEL_1 | TIM_CHANNEL_2);
  HAL_TIM_Encoder_Start(&htim4, TIM_CHANNEL_1 | TIM_CHANNEL_2);
  HAL_TIM_Encoder_Start(&htim8, TIM_CHANNEL_1 | TIM_CHANNEL_2);


  HAL_TIM_Base_Start_IT(&htim6);

/*



  // thrower
  HAL_TIM_PWM_Start(&htim17, TIM_CHANNEL_1);

  HAL_GPIO_TogglePin(DRV_OFF_GPIO_Port, DRV_OFF_Pin);
  HAL_Delay(10);
  //HAL_GPIO_TogglePin(DRV_OFF_GPIO_Port, DRV_OFF_Pin);
  HAL_Delay(10);
  HAL_GPIO_TogglePin(M1_DIR_GPIO_Port, M2_DIR_Pin);

  HAL_TIM_Encoder_Start(&htim3, TIM_CHANNEL_1 | TIM_CHANNEL_2);
  HAL_TIM_Encoder_Start(&htim4, TIM_CHANNEL_1 | TIM_CHANNEL_2);
  HAL_TIM_Encoder_Start(&htim8, TIM_CHANNEL_1 | TIM_CHANNEL_2);

  TIM17->CCR1 = 0; // set grabber to stop
  //TIM16->CCR1 = 4000; // set thrower to stop (4000)
  HAL_Delay(2000);
  */
  /* USER CODE END 2 */

  /* Infinite loop */
  /* USER CODE BEGIN WHILE */


  while (1)
  {

	  uint8_t n = HAL_GPIO_ReadPin(BALL_SENSOR_GPIO_Port, BALL_SENSOR_Pin);

	  if (isCommandReceived){
		  isCommandReceived = 0;
		  tgt_M1 = command.speed1;
		  tgt_M2 = command.speed2;
		  tgt_M3 = command.speed3;
		  thrower_speed = command.thrower_speed;
		  uint8_t bools = command.bools;

		  if (bools >= 2)
		  {
		  	  bools -= 2;
		  	  grabber_on = 1;
		  }

		  else
		  {
			  grabber_on = 0;
		  }

		  if (bools >= 1)
		  {
			  bools -= 1;
			  thrower = 1;
		  }

		  HAL_GPIO_WritePin(DRV_OFF_GPIO_Port, DRV_OFF_Pin, 0);

		  safety_iters = 0;

		  feedback.bools = (uint8_t)HAL_GPIO_ReadPin(BALL_SENSOR_GPIO_Port, BALL_SENSOR_Pin);
		  feedback.deliminer = 0xAAAA;
		  CDC_Transmit_FS(&feedback, sizeof(feedback));


	  }



	  if (grabber_on){

		  if (n)
		  {
			  TIM17->CCR1 = 0;
			  grabber_on = 0;

		  }
		  else TIM17->CCR1 = 1000;

	  }

	  else TIM17->CCR1 = 0;
	  if (n) grabber_on = 0;

	  if(thrower && n){
		  throw(thrower_speed);
	  }
	  else thrower = 0;

	  if (safety_iters > 100){
		  HAL_GPIO_WritePin(DRV_OFF_GPIO_Port, DRV_OFF_Pin, 1);
		  tgt_M1 = 0;
		  tgt_M2 = 0;
		  tgt_M3 = 0;
	  }


  }
    /* USER CODE END WHILE */

}

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
