ut-robotics/picr21-team-tlo-rock/workspace_1.8.0/TLO_Rock_PCB_Firmware/TLO_Rock_PCB_Firmware.ioc

Mcu.UserName=STM32G441KBTx
PA0.GPIO_Label=TIM2_CH1_M1_PWM
PA0.Signal=S_TIM2_CH1
PA1.GPIO_Label=M1_DIR
PA1.Signal=GPIO_Output
PA10.GPIO_Label=M2_DIR
PA10.Signal=GPIO_Output
PA11.Signal=USB_DM
PA12.Signal=USB_DP
PA13.Signal=SYS_JTMS-SWDIO
PA14.Signal=SYS_JTCK-SWCLK
PA15.GPIO_Label=TIM8_CH1_ENCA
PA15.Signal=S_TIM8_CH1
PA2.GPIO_Label=TIM_15_CH1_M3_PWM
PA2.Signal=S_TIM15_CH1
PA3.GPIO_Label=M3_DIR
PA3.Signal=GPIO_Output
PA4.GPIO_Label=TIM3_CH2_ENCB
PA4.Signal=S_TIM3_CH2
PA5.GPIO_Label=BALL_SENSOR
PA5.Signal=GPIO_Input
PA6.GPIO_Label=TIM3_CH1_ENCA
PA6.Signal=S_TIM3_CH1
PA7.GPIO_Label=TIM17_CH1_THW_SERVO
PA7.Signal=S_TIM17_CH1
PA8.Signal=I2C3_SCL
PA9.GPIO_Label=TIM2_CH3_M2_PWM
PA9.Signal=S_TIM2_CH3
PB0.GPIO_Label=DRV_OFF
PB0.Signal=GPIO_Output
PB3.GPIO_Label=NSLEEP_PWM
PB3.Signal=S_TIM2_CH2
PB4.GPIO_Label=TIM16_CH1_THW_MOTOR
PB4.Signal=S_TIM16_CH1
PB5.Signal=I2C3_SDA
PB6.GPIO_Label=TIM4_CH1_ENCA
PB6.Signal=S_TIM4_CH1
PB7.GPIO_Label=TIM4_CH2_ENCB
PB7.Signal=S_TIM4_CH2
PB8-BOOT0.GPIO_Label=TIM8_CH2_ENCB
PB8-BOOT0.Signal=S_TIM8_CH2
