ut-robotics/picr21-team-tlo-rock/workspace_1.8.0/tlo/Core/Inc/main.h

#define TIM2_VH1_M1_PWM_Pin GPIO_PIN_0
#define TIM2_VH1_M1_PWM_GPIO_Port GPIOA
#define M1_DIR_Pin GPIO_PIN_1
#define M1_DIR_GPIO_Port GPIOA
#define M3_DIR_Pin GPIO_PIN_3
#define M3_DIR_GPIO_Port GPIOA
#define TIM3_CH2_ENCB_Pin GPIO_PIN_4
#define TIM3_CH2_ENCB_GPIO_Port GPIOA
#define BALL_SENSOR_Pin GPIO_PIN_5
#define BALL_SENSOR_GPIO_Port GPIOA
#define TIM3_CH1_ENCA_Pin GPIO_PIN_6
#define TIM3_CH1_ENCA_GPIO_Port GPIOA
#define TIM17_CH1_THW_SERVO_Pin GPIO_PIN_7
#define TIM17_CH1_THW_SERVO_GPIO_Port GPIOA
#define DRV_OFF_Pin GPIO_PIN_0
#define DRV_OFF_GPIO_Port GPIOB
#define TIM2_CH3_M2_PWM_Pin GPIO_PIN_9
#define TIM2_CH3_M2_PWM_GPIO_Port GPIOA
#define M2_DIR_Pin GPIO_PIN_10
#define M2_DIR_GPIO_Port GPIOA
#define NSLEEP_PWM_Pin GPIO_PIN_3
#define NSLEEP_PWM_GPIO_Port GPIOB
#define TIM16_CH1_THW_MOTOR_Pin GPIO_PIN_4
#define TIM16_CH1_THW_MOTOR_GPIO_Port GPIOB
#define TIM4_CH1_ENCA_Pin GPIO_PIN_6
#define TIM4_CH1_ENCA_GPIO_Port GPIOB
#define TIM4_CH2_ENCB_Pin GPIO_PIN_7
#define TIM4_CH2_ENCB_GPIO_Port GPIOB
