ut-robotics/picr21-team-tlo-rock/robot code/enums.py

from enum import IntEnum
class State(IntEnum):
    stopped = 0
    automatic = 1
    remote = 2
    calibration = 3
class GameState(IntEnum):
    searching = 0
    moveto = 1
    orbit = 2
    launch = 3
    search_basket = 4
class Side(IntEnum):
    pink = 0
    blue = 1
