ut-robotics/picr21-team-tlo-rock/(commit log)

2021-09-27 tinkering on adding arrays to the camera process
2021-10-07 first bugfixes on robot multiprocessing
    [Camera.py, Localization.py, main.py]
2021-10-07 Fixed the algorithm for finding the nearest ball
    [Camera.py, Localization.py]
2021-10-11 Fixing aquiring ball coordinates. First following!
    [Camera.py, Localization.py, Thresholding.py, main.py, movement_controller.py]
2021-10-13 fixed distance broke ball following
    [Camera.py, Localization.py, Thresholding.py, movement_controller.py]
2021-10-14 implemented new threshold formatting to camera
2021-10-21 adding switch between manual and automatic control
2021-10-25 now using map for linear velocity
2021-10-25 fixed a few things
    [main.py, movement_controller.py]
2021-11-01 upping the camera resolution and fps
2021-11-08 addressed array creation issue
    [Camera.py]
2021-11-08 tuning the camera code
2021-11-08 Conducted tests to try and remove repetition. Added conclusions to github issue.
    [Thresholding.py]
2021-11-08 moved the state switching to key release
2021-11-12 adding a temporary fix for extra variables
    [Camera.py]
2021-11-15 reworking camera thresholding
2021-11-17 Revert "enum to intEnum and added way to see how longsince last detection of ball"
    This reverts commit 4a96e21de9e183be898bb43949d694850aaa0862.
    [Localization.py, enums.py, game_logic.py, main.py]
2021-11-18 fixed adding coords the output of getKeyPoints is 3 lists even if the lists contain 1 value
    [Camera.py]
2021-11-24 changed basket selection to camera
2021-11-26 now capable of basic calibration
2021-11-29 camera should be in meters now and shooting cal is recording with constant speed
2021-11-29 solved issue with ._value_ in main
    [main.py]
2021-11-29 switched over to getDistance
2021-12-01 calibrated based on sensor distance and added new function to options
2021-12-06 edited lin velocity
2021-12-06 added camera line concept picture
2021-12-11 Made changes based on instructor feedback
    [PCB.PcbDoc, motor_DRV.SchDoc, motor_MCU.SchDoc]
2021-12-13 Latest changes
    [PCB.PcbDoc]
2021-12-15 changed linear servo regulator to buck converter
    [PCB.PcbDoc, motor_MCU.SchDoc]
2021-12-16 combined thresholding and camera code
2021-12-17 Fixed some issues
    [PCB.PcbDoc, motor_DRV.SchDoc, motor_MCU.SchDoc]
2021-12-23 Added components
    [PDRV8243HRXYQ1.PcbLib, TPS54227DDA.SchLib, VREG_LM5017MR_NOPB.PcbLib, Wurth_Electronics_744777930.SchLib, Wurth_Electronics_744777930_0.PcbLib]
2021-12-23 Updated servo regulator
    [PCB.PcbDoc, TLO Rock electronics.PrjPcb, motor_DRV.SchDoc, motor_MCU.SchDoc]
2021-12-31 Fixed mechanical layer issues and servo power
    [PCB.PcbDoc, motor_DRV.SchDoc, motor_MCU.SchDoc, nahhui idioot.PcbDoc]
2022-01-02 updated libraries
    [SnapEDApcb.PcbLib, SnapEDAsch.SchLib]
2022-01-04 merging thresholding and camera code
2022-01-06 Fixed driver footprint solder mask expansion
    [PDRV8243HRXYQ1.PcbLib]
2022-01-06 Fixed ssue #33
    [PCB.PcbDoc]
2022-01-07 Updated switching regulator footprint
    [VREG_LM5017MR_NOPB.PcbLib]
2022-01-07 Fixed sw.reg thermal pad gndb
    [PCB.PcbDoc]
2022-01-07 Added PCB manufacturing files
2022-01-07 updated polygons
    [PCB.PcbDoc, TLO Rock electronics.PrjPcb]
2022-01-13 Changed RTRIP resistor
    [motor_DRV.SchDoc]
2022-01-17 now alligning depth frames
2022-01-21 pcb has been tested
2022-01-22 saving just in case
2022-01-22 stm pid base done
2022-01-24 Made schematics nicer and changed resistor values
    [PCB.PcbDoc, TLO Rock electronics.PrjPcb, motor_DRV.SchDoc, motor_MCU.SchDoc]
2022-01-25 el debug
2022-01-25 Added mainboard documentation
    [Mainboard BOM.xlsx]
2022-01-25 fixed timer 15
2022-01-26 only missing field edge detection
    [Camera.py, game_logic.py, main.py, newcom.py]
2022-01-26 additional failsafe when no balls visible
    [game_logic.py]
2022-01-26 fixed important bug when discarding balls
    [Camera.py]
2022-01-26 inserting referee client
2022-01-26 new calibration for competition field
2022-01-26 last calibration
