ut-robotics/picr21-team-tlo-rock/(notices)

Notices in the files:
workspace_1.8.0/tlo/Core/Inc/main.h:
Copyright (c) 2022 STMicroelectronics.
All rights reserved.
This software is licensed under terms that can be found in the LICENSE file
